OpenDrone-hw/OpenRX-Mono/README.md

# OpenRX Mono

Open-source dual-band (868/915 MHz and 2.4 GHz) ExpressLRS radio control receiver
module with telemetry, for any radio-controlled build: cars, boats, robots and
aircraft. OpenRX Mono uses an ESP32-C3 and one LR1121 with a 2.4 GHz PA/LNA,
sub-GHz matching network and a shared U.FL antenna interface.
It passes the received channels over serial (CRSF) on its RX and TX pads to a
controller, for example a flight controller or a vehicle or robot controller.

<p>
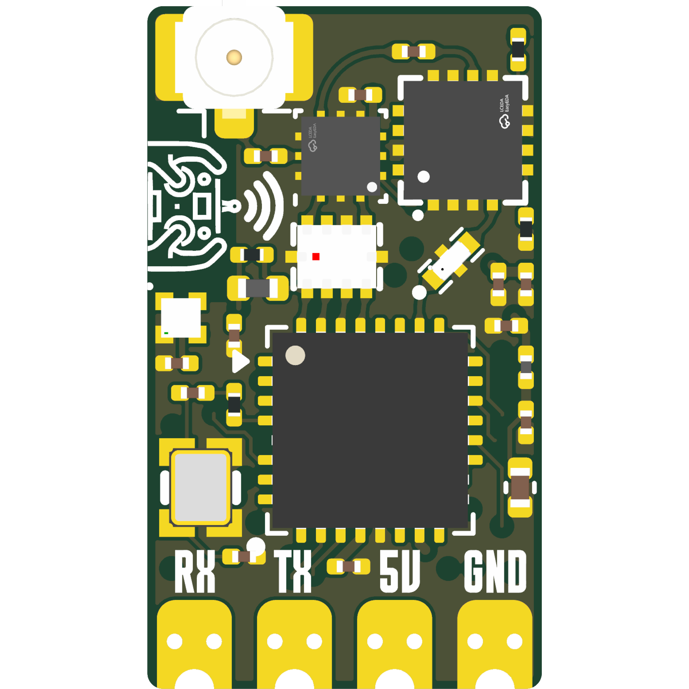
[picture p1: images/front.png]
OpenRX Mono front

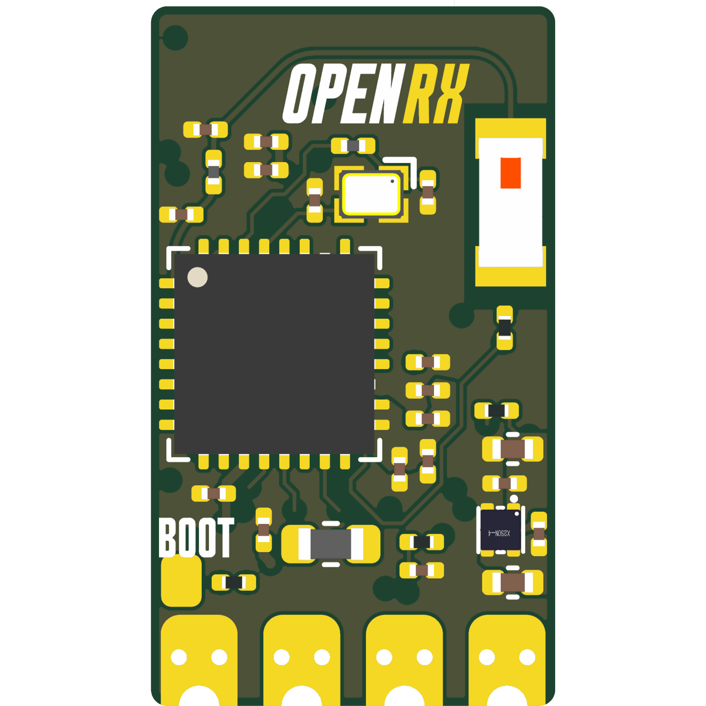
[picture p2: images/back.png]
OpenRX Mono back

</p>







## Specifications

| | |
|---|---|
| Band | 2.4 GHz and sub-GHz |
| Radio | LR1121 |
| Antenna | U.FL |
| Telemetry power | Up to 22 dBm (158 mW) |
| Protocol | CRSF |
| MCU | ESP32-C3 |
| Input | 5 V pad |
| Firmware | ExpressLRS |
| Flashing | Betaflight passthrough or Wi-Fi |
| Dimensions | 10.0 x 17.3 mm |
| PCB | 6-layer, 1.0 mm |

Technical write-up, part list and layout constraints: [AGENTS.md](AGENTS.md).

## In the line

What pairs with what, and what is available:
[opendrone.be](https://opendrone.be).

## Contributing

See [CONTRIBUTING.md](CONTRIBUTING.md).

## License

Hardware licensed under [CERN-OHL-S-2.0](https://ohwr.org/cern_ohl_s_v2.txt),
see [LICENSE](LICENSE).
