OpenDrone-hw/OpenRX-Mono/hardware/OpenRX-Mono.kicad_pcb

## KiCad design hardware/OpenRX-Mono.kicad_pcb (2026-09-19)

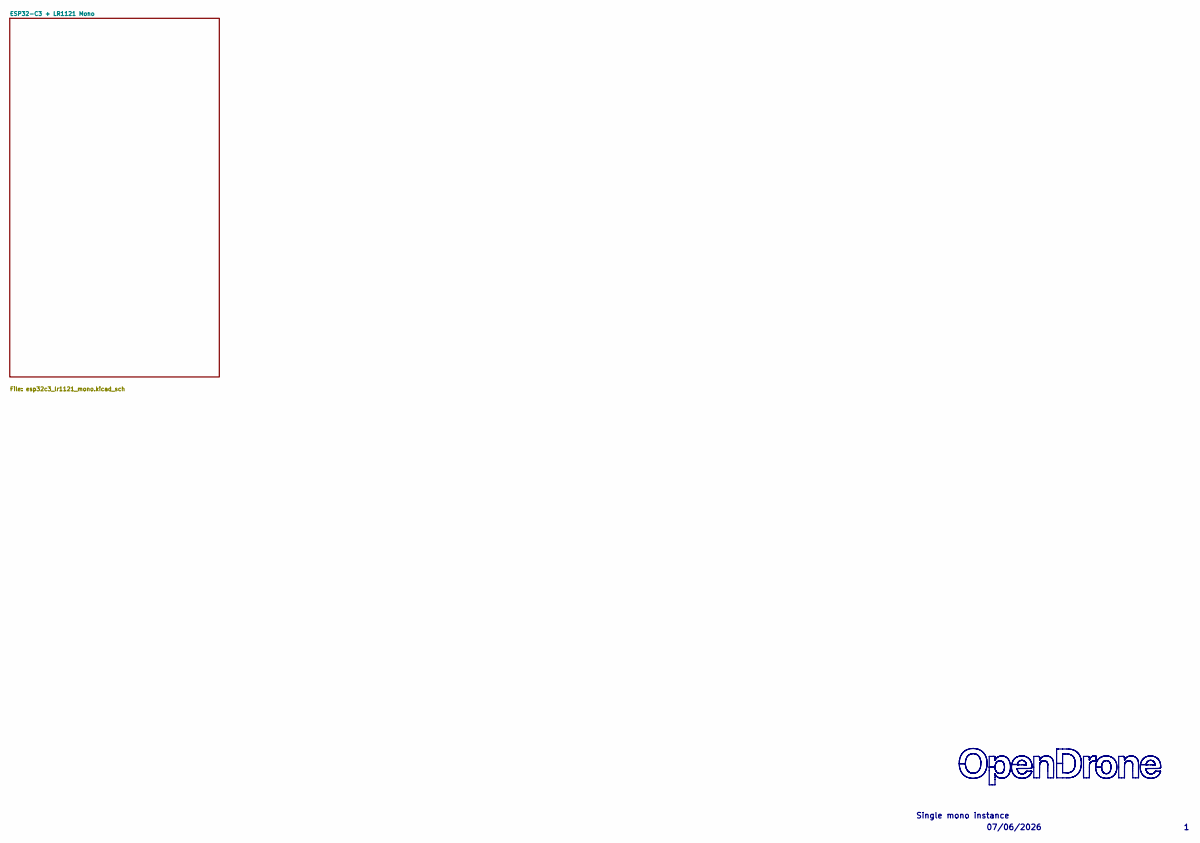
[picture p3: schematic OpenRX-Mono.kicad_sch]

Notes on the sheet:
07/06/2026
Single mono instance

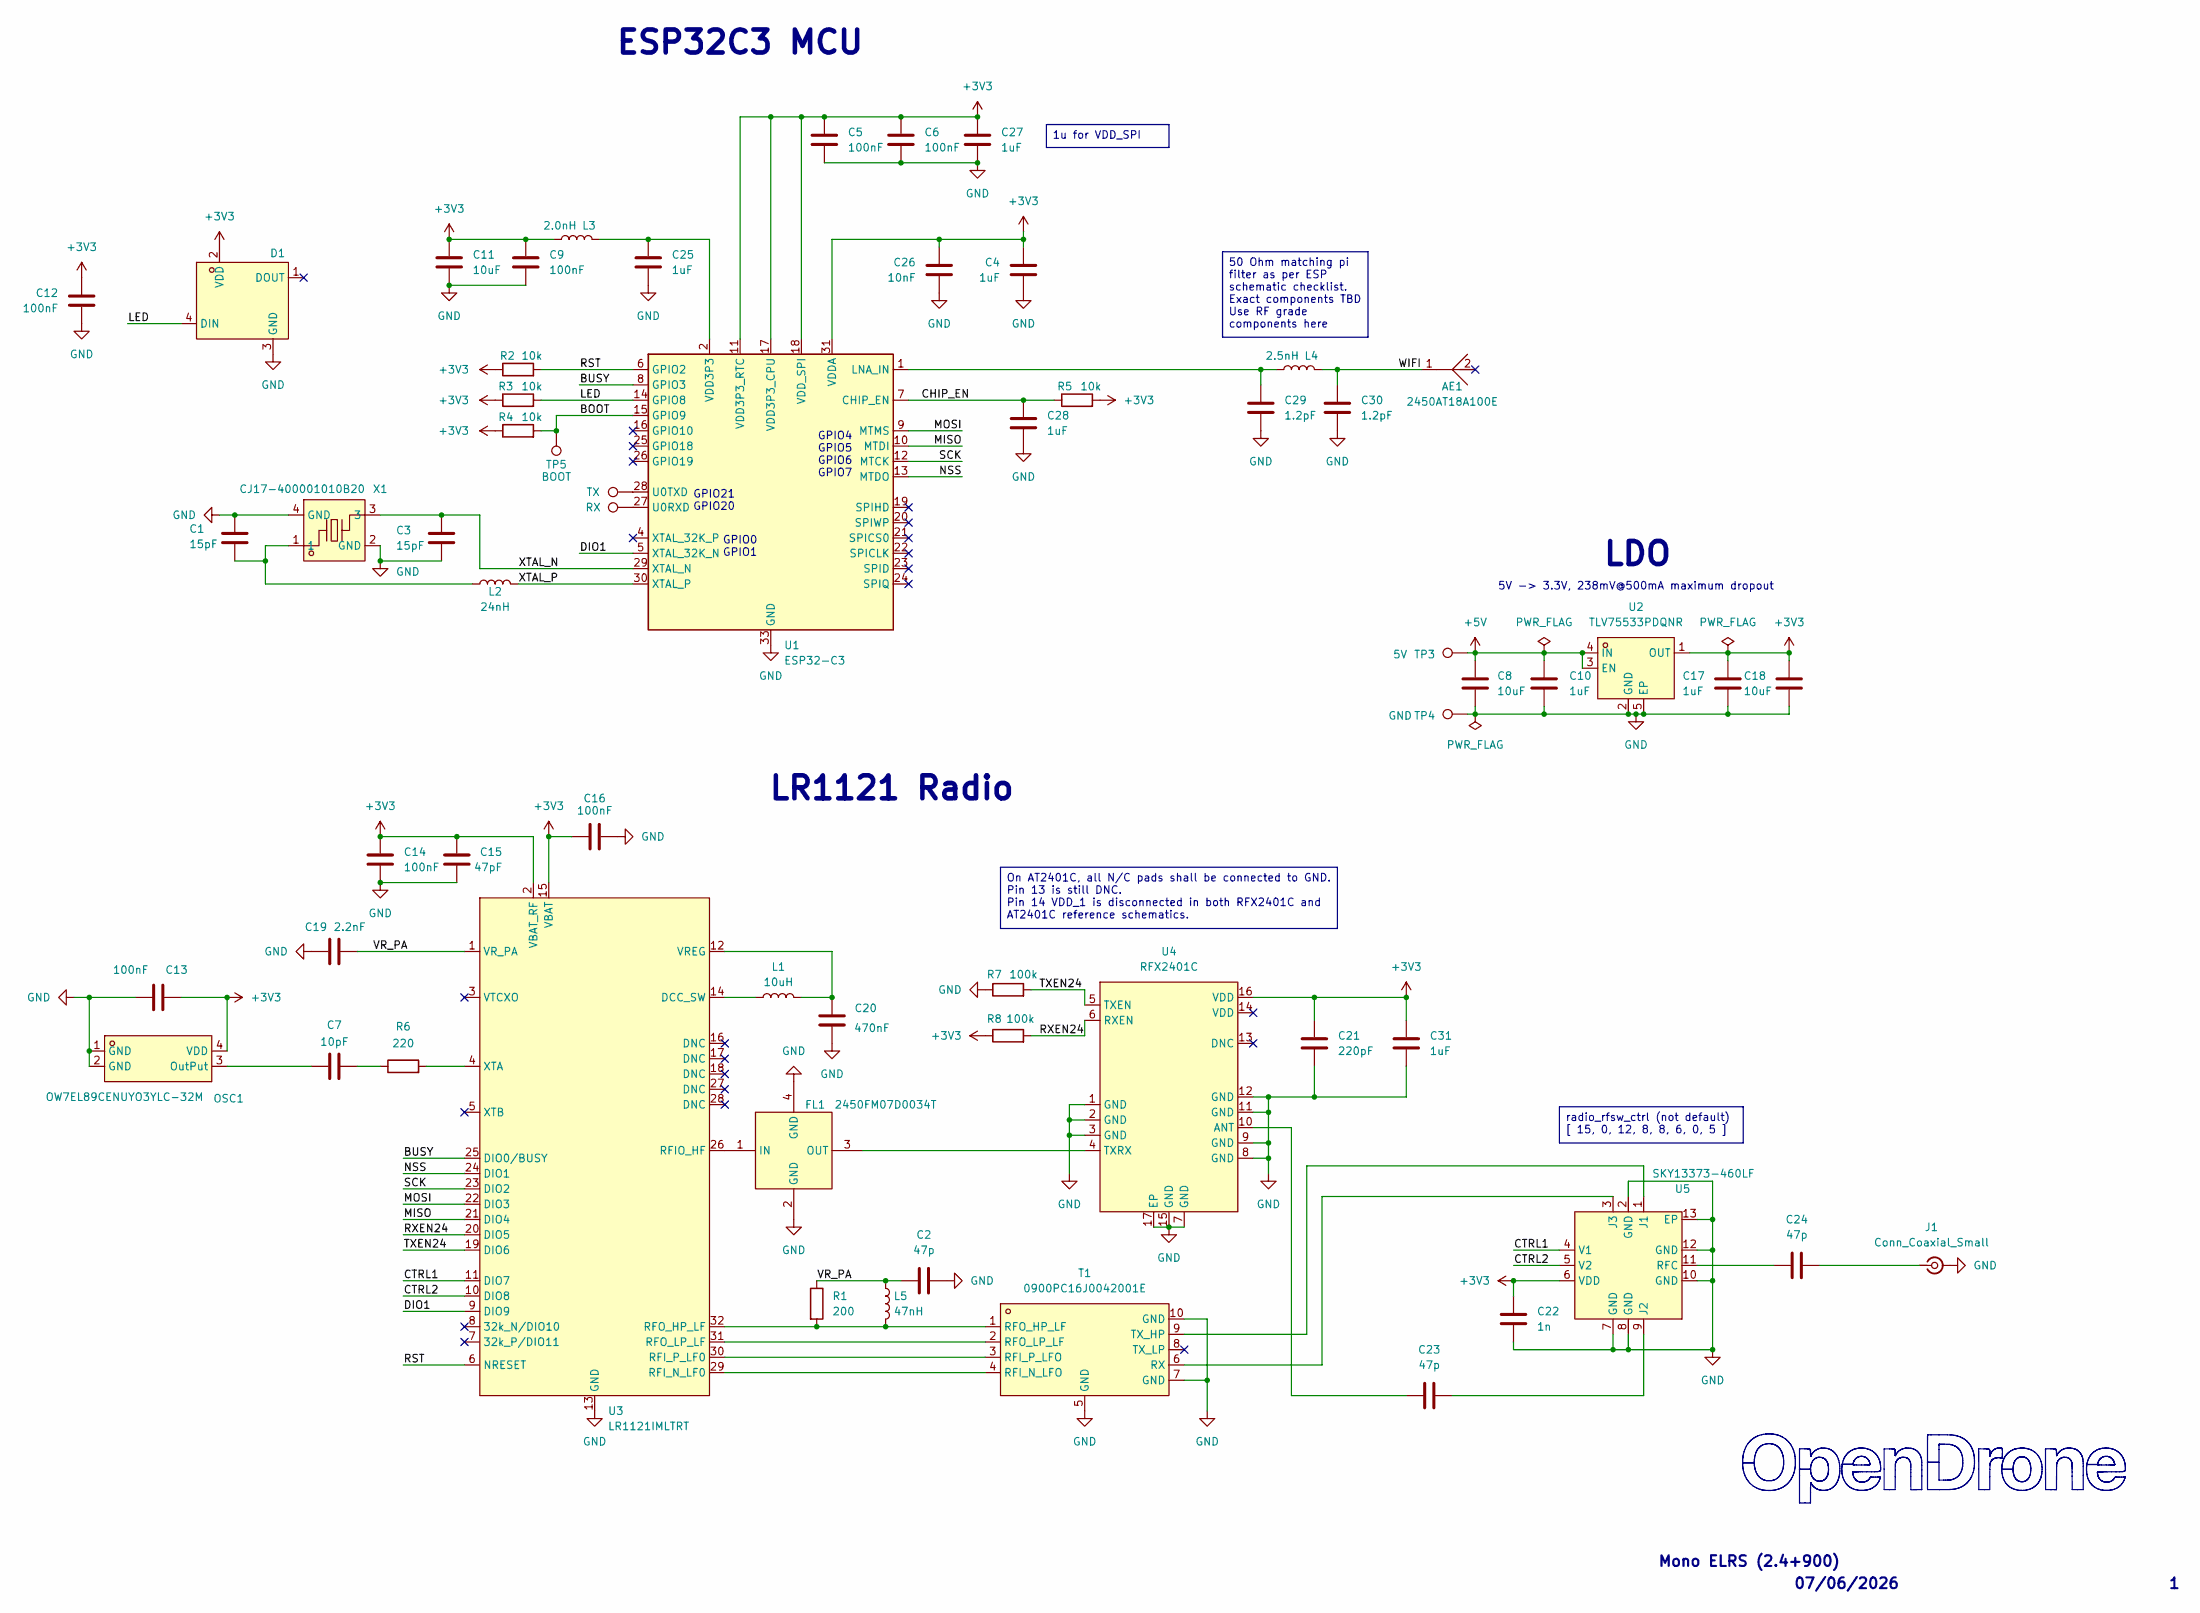
[picture p4: schematic esp32c3_lr1121_mono.kicad_sch]

Parts:
AE1: 2450AT18A100E; ANT-SMD_L3.2-W1.6; MPN 2450AT18A100E; LCSC Part C89334
C1, C3: 15pF; C_0201_0603Metric; MPN GRM0335C1H150JA01D; LCSC C85891
C2, C23, C24: 47p; C_0201_0603Metric; MPN GRM0335C1H470JA01D; LCSC C85908
C4, C10, C17, C25, C27, C28, C31: 1uF; C_0201_0603Metric; MPN GRM033R61A105ME44D; LCSC C76935
C5, C6, C9, C12, C13, C14, C16: 100nF; C_0201_0603Metric; MPN GRM033R61E104KE14D; LCSC C76939
C7: 10pF; C_0201_0603Metric; MPN GRM0335C1H100FA01D; LCSC C384956
C8, C18: 10uF; C_0402_1005Metric; MPN CL05A106MQ5NUNC; LCSC C15525
C11: 10uF; C_0402_1005Metric; MPN GRM155R60J106ME44D; LCSC C76991
C15: 47pF; C_0201_0603Metric; MPN GRM0335C1H470JA01D; LCSC C85908
C19: 2.2nF; C_0201_0603Metric; MPN GRM033R71E222KA12D; LCSC C161488
C20: 470nF; C_0201_0603Metric; MPN GRM033R60J474KE90D; LCSC C85926
C21: 220pF; C_0201_0603Metric; MPN GRM0335C1E221JA01D; LCSC C907939
C22: 1n; C_0201_0603Metric; MPN GRM033R71H102KA12D; LCSC C85934
C26: 10nF; C_0201_0603Metric; MPN GRM033R61A103KA01J; LCSC C2168164
C29, C30: 1.2pF; C_0201_0603Metric; MPN GRM0335C1H1R2BA01D; LCSC C85895
D1: XL-1010RGBC-WS2812B; LED-SMD_4P-L1.0-W1.0-TL_XL-1010RGBC-WS2812B; MPN XL-1010RGBC-2812B; LCSC C5349953
FL1: 2450FM07D0034T; FILTER-SMD_4P-L1.0-W0.5-L; MPN 2450FM07D0034T; LCSC Part_1 C2651081
J1: Conn_Coaxial_Small; U.FL_Hirose_U.FL-R-SMT-1_Vertical; MPN U.FL-R-SMT-1(80); LCSC C88374
L1: 10uH; L_0603_1608Metric; MPN MLZ1608N100LT000; LCSC C194437
L2: 24nH; L_0201_0603Metric; MPN LQP03TN24NH02D; LCSC C206441
L3: 2.0nH; L_0201_0603Metric; MPN LQP03TN2N0B02D; LCSC C86125
L4: 2.5nH; L_0201_0603Metric; MPN LQP03TN2N5C02D; LCSC C206435
L5: 47nH; L_0402_1005Metric; MPN LQW15AN47NJ00D; LCSC C192855
OSC1: OW7EL89CENUYO3YLC-32M; OSC-SMD_4P-L2.0-W1.6-BL_TXC_7Z; MPN OW7EL89CENUYO3YLC-32M; LCSC C22381772
R1: 200; R_0201_0603Metric; MPN RC0201FR-07200RL; LCSC C274337
R2, R3, R4, R5: 10k; R_0201_0603Metric; MPN RC0201FR-0710KL; LCSC C106225
R6: 220; R_0201_0603Metric; MPN ERJ-1GNF2200C; LCSC C2074788
R7, R8: 100k; R_0201_0603Metric; MPN RC0201FR-07100KL; LCSC C106224
T1: 0900PC16J0042001E; FILTER-SMD_10P-L2.0-W1.6-BL; MPN 0900PC16J0042001E; LCSC C19842466
TP1: RX; SolderPad_1.2x2.0mm
TP2: TX; SolderPad_1.2x2.0mm
TP3: 5V; SolderPad_1.2x2.0mm
TP4: GND; SolderPad_1.2x2.0mm
TP5: BOOT; SolderPad_1.2x2.0mm
U1: ESP32-C3; QFN-32-1EP_5x5mm_P0.5mm_EP3.7x3.7mm; MPN ESP32-C3FH4; LCSC C2858491
U2: TLV75533PDQNR; X2SON-4_L1.0-W1.0-P0.65-TL-EP; MPN TLV75533PDQNR; LCSC Part C2861882
U3: LR1121IMLTRT; QFN-32-1EP_5x5mm_P0.5mm_EP3.7x3.7mm; MPN LR1121IMLTRT; LCSC C7498014
U4: RFX2401C; QFN-16_L3.0-W3.0-P0.50-BL-EP1.7; MPN RFX2401C; LCSC C19213
U5: SKY13373-460LF; QFN-12_EP_2x2_Pitch0.5mm; MPN SKY13373-460LF; LCSC C150853
X1: CJ17-400001010B20; CRYSTAL-SMD_4P-L1.6-W1.2-BL; MPN CJ17-400001010B20; LCSC Part C2875272

Connections:
+3V3: C4.1, C5.1, C6.1, C9.1, C11.1, C12.1, C13.2, C14.1, C15.1, C16.1, C17.1, C18.1, C21.1, C22.1, C26.1, C27.1, C31.1, D1.2 (VDD), L3.2, OSC1.4 (VDD), R2.1, R3.1, R4.1, R5.2, R8.1, U1.11 (VDD3P3_RTC), U1.17 (VDD3P3_CPU), U1.18 (VDD_SPI), U1.31 (VDDA), U1.32 (VDDA), U2.1 (OUT), U3.2 (VBAT_RF), U3.15 (VBAT), U4.16 (VDD), U5.6 (VDD)
+5V: C8.1, C10.1, TP3.1 (1_1), U2.3 (EN), U2.4 (IN)
/ESP32-C3 + LR1121 Mono/BOOT: R4.2, TP5.1 (1_1), U1.15 (GPIO9)
/ESP32-C3 + LR1121 Mono/BUSY: U1.8 (GPIO3), U3.25 (DIO0/BUSY)
/ESP32-C3 + LR1121 Mono/CHIP_EN: C28.1, R5.1, U1.7 (CHIP_EN)
/ESP32-C3 + LR1121 Mono/CTRL1: U3.11 (DIO7), U5.4 (V1)
/ESP32-C3 + LR1121 Mono/CTRL2: U3.10 (DIO8), U5.5 (V2)
/ESP32-C3 + LR1121 Mono/DIO1: U1.5 (XTAL_32K_N), U3.9 (DIO9)
/ESP32-C3 + LR1121 Mono/LED: D1.4 (DIN), R3.2, U1.14 (GPIO8)
/ESP32-C3 + LR1121 Mono/MISO: U1.10 (MTDI), U3.21 (DIO4)
/ESP32-C3 + LR1121 Mono/MOSI: U1.9 (MTMS), U3.22 (DIO3)
/ESP32-C3 + LR1121 Mono/NSS: U1.13 (MTDO), U3.24 (DIO1)
/ESP32-C3 + LR1121 Mono/RST: R2.2, U1.6 (GPIO2), U3.6 (NRESET)
/ESP32-C3 + LR1121 Mono/RXEN24: R8.2, U3.20 (DIO5), U4.6 (RXEN)
/ESP32-C3 + LR1121 Mono/SCK: U1.12 (MTCK), U3.23 (DIO2)
/ESP32-C3 + LR1121 Mono/TXEN24: R7.2, U3.19 (DIO6), U4.5 (TXEN)
/ESP32-C3 + LR1121 Mono/VR_PA: C2.1, C19.1, L5.1, R1.1, U3.1 (VR_PA)
/ESP32-C3 + LR1121 Mono/WIFI: AE1.1, C30.1, L4.1
/ESP32-C3 + LR1121 Mono/XTAL_N: C3.1, U1.29 (XTAL_N), X1.3
/ESP32-C3 + LR1121 Mono/XTAL_P: L2.2, U1.30 (XTAL_P)
GND: C1.2, C2.2, C3.2, C4.2, C5.2, C6.2, C8.2, C9.2, C10.2, C11.2, C12.2, C13.1, C14.2, C15.2, C16.2, C17.2, C18.2, C19.2, C20.1, C21.2, C22.2, C25.2, C26.2, C27.2, C28.2, C29.2, C30.2, C31.2, D1.3 (GND), FL1.2 (GND), FL1.4 (GND), J1.2 (Ext), OSC1.1 (GND), OSC1.2 (GND), R7.1, T1.5 (GND), T1.7 (GND), T1.10 (GND), TP4.1 (1_1), U1.33 (GND), U2.2 (GND), U2.5 (EP), U3.13 (GND), U3.33 (EP), U4.1 (GND), U4.2 (GND), U4.3 (GND), U4.7 (GND), U4.8 (GND), U4.9 (GND), U4.11 (GND), U4.12 (GND), U4.15 (GND), U4.17 (EP), U5.2 (GND), U5.7 (GND), U5.8 (GND), U5.10 (GND), U5.12 (GND), U5.13 (EP), X1.2 (GND), X1.4 (GND)
unnamed: C1.1, L2.1, X1.1
unnamed: C7.1, R6.1
unnamed: C25.1, L3.1, U1.2 (VDD3P3), U1.3 (VDD3P3)
unnamed: FL1.1 (IN), U3.26 (RFIO_HF)
unnamed: FL1.3 (OUT), U4.4 (TXRX)
unnamed: C24.2, J1.1 (In)
unnamed: C7.2, OSC1.3 (OutPut)
unnamed: T1.4 (RFI_N_LFO), U3.29 (RFI_N_LF0)
unnamed: T1.3 (RFI_P_LFO), U3.30 (RFI_P_LF0)
unnamed: L5.2, R1.2, T1.1 (RFO_HP_LF), U3.32 (RFO_HP_LF)
unnamed: T1.2 (RFO_LP_LF), U3.31 (RFO_LP_LF)
unnamed: T1.6 (RX), U5.3 (J3)
unnamed: T1.9 (TX_HP), U5.1 (J1)
unnamed: C29.1, L4.2, U1.1 (LNA_IN)
unnamed: TP1.1 (1_1), U1.27 (U0RXD)
unnamed: TP2.1 (1_1), U1.28 (U0TXD)
unnamed: L1.1, U3.14 (DCC_SW)
unnamed: C20.2, L1.2, U3.12 (VREG)
unnamed: R6.2, U3.4 (XTA)
unnamed: C23.1, U4.10 (ANT)
unnamed: C23.2, U5.9 (J2)
unnamed: C24.1, U5.11 (RFC)

Notes on the sheet:
GPIO0 GPIO1
LR1121 Radio
GPIO21 GPIO20
5V -> 3.3V, 238mV@500mA maximum dropout
07/06/2026
ESP32C3 MCU
LDO
Mono ELRS (2.4+900)
GPIO4 GPIO5 GPIO6 GPIO7
On AT2401C, all N/C pads shall be connected to GND. Pin 13 is still DNC. Pin 14 VDD_1 is disconnected in both RFX2401C and AT2401C reference schematics.
50 Ohm matching pi filter as per ESP schematic checklist. Exact components TBD Use RF grade components here
radio_rfsw_ctrl (not default) [ 15, 0, 12, 8, 8, 6, 0, 5 ]
1u for VDD_SPI

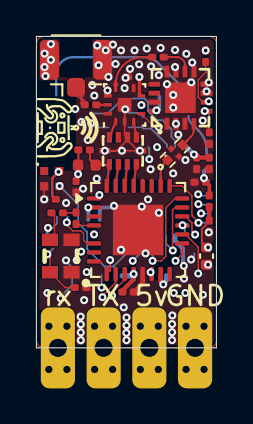
[picture p5: board OpenRX-Mono.kicad_pcb from above]

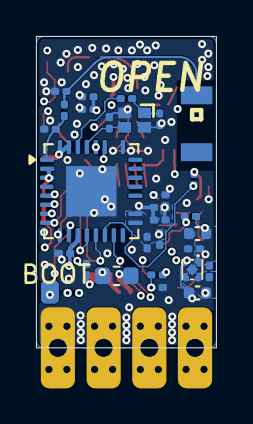
[picture p6: board OpenRX-Mono.kicad_pcb from below]

Board: 6 copper layers, 10.0 x 17.3 mm, 61 parts (30 on the bottom side), 43 nets.
