OpenDrone-hw/OpenRX-Mono/(commit log)

2026-03-23 Consolidate docs: 1 README + KICAD_WORKFLOW + 1 DESIGN.md per receiver
    - Merge SCHEMATIC.md + BOM.md into single DESIGN.md per receiver
    - Delete OPENRX_ELRS_4_RECEIVER_PORTFOLIO.md (content integrated)
    - Delete REPO_AUDIT_2026-03-23.md (issues addressed)
    - Fold CORE_BOM into README.md architecture table
    - Rename KICAD_WORKFLOW_AND_ELRS_COMPATIBILITY.md to KICAD_WORKFLOW.md
    - Rewrite KICAD_WORKFLOW with step-by-step capture instructions
    - Add shared libs and starter shared sheet from audit agent
2026-03-23 Fix all DESIGN.md: RFX2401C, DEA LPF, LR1121 pinout, FEM control
    - Lite: remove L-match network, use DEA102700LT-6307A2 only
    - Nano: clarify DEA LPF path, mark 0.3pF as mandatory, SE2431L as EOL
    - 900: fix LR1121 RFSW description, confirm 4x4mm package
    - Dual: SE2431L→RFX2401C, FEM via LR1121 RFSW not MCU GPIO, BOM $9→$7.62
    - PWM: SE2431L→RFX2401C, DEA LPF + 0.3pF path, BOM $7.40→$6.02
    - Gemini: SE2431L→RFX2401C, fix FEM control model, BOM $10.84→$9.46
2026-03-23 Update all DESIGN.md: TLV75533 X2SON LDO, XL-1010 1x1mm LED
    - Lite/Nano/900/Dual: ME6211 SOT-23-5 → TLV75533PDQNR X2SON-4 (1x1mm)
    - Gemini: keeps AP2112K (600mA needed for dual radios)
    - PWM: keeps AMS1117 (needs >6V input range)
    - All: WS2812B-2020 → XL-1010RGBC-WS2812B (1x1mm)
    - Updated cap values for TLV755 (1uF local + 10uF bulk)
2026-03-23 Import U.FL-R-SMT-1(80) UFL connector into shared library (C88374)
2026-03-23 Import Molex 479480001 tower ceramic antenna (C152351) for ELRS RF
2026-03-23 Add solder pad footprints: 1.0x1.5mm and 1.0x0.8mm compact
2026-03-23 Unify library tables, import RFX2401C, Lite schematic capture
    - All 6 projects now share OpenRX-Shared + OpenRX-Lite lib tables
    - Import RFX2401C (C19213) into shared library with 3D model path fix
    - OpenRX-Lite schematic: 0 ERC errors (captured in KiCad GUI)
    - Add .gitignore for .lck and .history files
2026-03-23 OpenRX-900: add all LCSC fields, fix 4.7uF to 0402
    - C20 (4.7uF): C23733, footprint fixed from 0201 to 0402
    - R5/R6/R7 (100k): C25741, RFSW pull-downs
    - L1 (10uH): C1035, 0603 DC-DC inductor
    - U4 (LR1121): C7498014
    - U5 (32MHz TCXO): C22434888
    - T1 (Johanson IPD): C19842466
    - JP1 (UFL): C88374
    - 0 ERC errors, all components have LCSC fields
2026-03-23 Fix Gemini crystal load caps to 18pF (C62164), matching Lite and Mono
    [OpenRX-Mono.kicad_pcb, OpenRX-Mono.kicad_sch, esp32c3_lr1121_mono.kicad_sch]
2026-03-23 Add LCSC C430052 for 24nH XTAL_P inductor on Mono
    Mono L2 (24nH 0201) was missing LCSC field.
    Lite still needs 24nH inductor added in KiCad GUI.
    Gemini is parked — still a Mono copy, not yet dual-radio.
    [esp32c3_lr1121_mono.kicad_sch]
2026-03-23 OpenRX-Gemini: dual LR1121 schematic complete, 0 ERC errors
    - Radio 1 (U4): sub-GHz via Johanson IPD → JP1 UFL
    - Radio 2 (U9): 2.4GHz via RFX2401C (U10) → DEA (USB2) → JP3 UFL
    - Shared SPI bus (SCK/MISO/MOSI), separate NSS/IRQ/BUSY/RST per radio
    - Radio 2 control: GPIO10=NSS2, GPIO9=IRQ2, GPIO1=BUSY2, GPIO0=RST2
    - FEM driven by Radio 2 RFSW (DIO5→RXEN, DIO6→TXEN)
    - Radio 1 DIO5/DIO6 have 100k pull-downs (disconnected from FEM)
    - No LED (GPIO10 used for NSS2), no boot button (GPIO9 used for IRQ2)
    - Still needs: 10k pull-up on NSS2
    [esp32c3_lr1121_mono.kicad_sch]
2026-03-23 Add SolderPad_1.2x2.0mm with 25% rounded corners, 2.0mm pitch standard
2026-03-23 Swap all solder pads to 1.2x2.0mm rounded (25%) across Lite, Mono, Gemini
    [esp32c3_lr1121_mono.kicad_sch]
2026-03-23 Swap 32MHz TCXO to smaller 2016 package (C22381772)
    OW2EL89 (3225, 3.2x2.5mm) → OW7EL89 (2016, 2.0x1.6mm)
    Same YXC family, same pinout, same specs. Saves 1.2x0.9mm per TCXO.
    Affects Mono (1x) and Gemini (2x).
    [esp32c3_lr1121_mono.kicad_sch]
2026-03-23 Import SKY13588-460LF SP3T RF switch (C2151906) into shared library
2026-03-23 Final topology: Mono + Gemini netlist with SKY13588 RF switch
    - SKY13588-460LF imported into shared library
    - Complete netlist for Mono (1×LR1121 + SKY13588 + Johanson IPD + DEA LPF → 1 UFL)
    - Gemini = 2× Mono RF chains + ESP32-C3 True Diversity GPIO mapping
    - GPIO maps match official ELRS Generic C3 LR1121 and True Diversity targets
    - Routing notes for RF paths included
    - Mono needs complete GPIO rewire to match ELRS target
2026-03-23 FINAL_NETLIST v3: SKY13588 as band combiner, RFX2401C kept for 100mW
    Based on RadioMaster XR4 teardown analysis:
    - SKY13588 serves as both sub-GHz path switch AND band combiner
    - Johanson IPD in direct-tie mode (RX/TX_LP/TX_HP joined) → SKY13588 J1
    - 2.4GHz: RFIO_HF → DEA LPF → RFX2401C → SKY13588 J2
    - SKY13588 RFC → DC block → UFL → dual-band antenna
    - RFX2401C kept for 100mW market parity
    - Button imported (C2976675, 3x2mm SMD)
    - RFSW truth table: DIO7/DIO8 control band, DIO5/DIO6 control RFX2401C
    [esp32c3_lr1121_mono.kicad_sch]
2026-03-23 Mono schematic v4: complete RF chain verified
    Verified netlist:
    - LR1121 → IPD (direct-tie, pins 6+8+9 joined) → SKY13588 J1 ✓
    - LR1121 RFIO_HF → DEA LPF → RFX2401C TXRX ✓
    - RFX2401C ANT → 0.3pF shunt → SKY13588 J2 ✓
    - SKY13588 RFC → UFL ✓
    - DIO7→V1, DIO8→V2 (band select) ✓
    - DIO5→RXEN, DIO6→TXEN (RFX2401C control) ✓
    - GPIO map matches Generic C3 LR1121 target ✓
    - Added LCSC to 220pF, RFX2401C, button
    - 1 ERC error: GPIO10 needs NC marker
    - 0.3pF has no LCSC (layout pad for tuning)
    [esp32c3_lr1121_mono.kicad_sch]
2026-03-24 Gemini: copy Mono schematic as base for dual-radio build
    [OpenRX-Mono.kicad_pcb, esp32c3_lr1121_mono.kicad_sch]
2026-03-24 Gemini: copy Mono schematic + PCB as starting point
    [OpenRX-Mono.kicad_pcb, esp32c3_lr1121_mono.kicad_sch]
2026-03-24 Copy Gemini PCB layout to Mono
    [OpenRX-Mono.kicad_pcb]
2026-03-24 Apply JLCPCB 6-layer advanced DRC rules to Mono and Gemini
    Rules applied:
    - Min clearance: 0.09mm (3.5mil)
    - Min track width: 0.09mm (3.5mil)
    - Min via diameter: 0.25mm
    - Min via drill: 0.15mm
    - Min annular ring: 0.05mm
    - Min hole-to-hole: 0.25mm
    - Default net class clearance: 0.09mm (was 0.2mm — this was the override)
    - Default track width: 0.1mm
    - Zone clearance: 0.09mm (was 0.5mm)
2026-03-24 Repo cleanup: final state for handoff
    - Clean README with architecture, BOM, CE notes, status
    - Remove dated analysis files (absorbed into FINAL_NETLIST + KICAD_WORKFLOW)
    - Remove stale OpenRX-Dual (archived), ERC reports, backups, prl files
    - Updated .gitignore for .kicad_dru, production backups
    - CERN-OHL-S v2 license confirmed
    - 3 active projects: Lite, Mono, Gemini
    - Schematics final, initial PCB layouts done, routing in progress
    [OpenRX-Mono.kicad_pcb, esp32c3_lr1121_mono.kicad_sch]
2026-04-06 Update schematics: Mono RF rewiring, SKY13414 port mapping, shared libs
    Mono: disconnect IPD TX_LP (unused by ELRS), route TX_HP→RF3, RX→RF1,
    RFX2401C ANT→RF4. Matches BetaFPV SuperX topology.
    [OpenRX-Mono.kicad_pcb, esp32c3_lr1121_mono.kicad_sch]
2026-04-06 Add Lite-UFL variant, ELRS targets, new footprints and 3D models
    - OpenRX-Lite-UFL: UFL antenna variant of Lite ceramic
    - ELRS target JSONs: Lite 2400, Mono LR1121, Gemini LR1121
    - radio_rfsw_ctrl: [15,0,0,8,8,14,0,13] for Mono/Gemini
    - SKY13414 QFN-14 footprint + 3D model
    - 2450FM07D0034 filter footprint
    - BOM LCSC passives script
2026-04-06 Add component datasheets and BOM index
    Local datasheet cache for all active RF components: LR1121, SX1281,
    SKY13414, SKY13373, RFX2401C, 2450FM07D0034, 0900PC16J0042001E,
    2000PC15C0040001E, 2450AT18A100E, BALF-SPI2-01D3, passives.
2026-04-06 Update all DESIGN.md docs: RF paths, GPIO maps, rfsw_ctrl, known bugs
    - Mono: new SKY13414 port mapping (RF1=RX, RF3=TX_HP, RF4=2.4GHz),
    rfsw_ctrl [15,0,0,8,8,14,0,13], GPIO map, impedance notes
    - Lite/Lite-UFL: GPIO map, no-boot-button note, SPI pin difference
    - Gemini: document DIO7-2/DIO8-2 wiring bug, stale component list
    - README: current lineup table
2026-04-21 initial routing for all
    [OpenRX-Mono.kicad_pcb, esp32c3_lr1121_mono.kicad_sch]
2026-04-27 final route
    [OpenRX-Mono.kicad_pcb]
2026-04-28 Set via netclass + dimension defaults to 0.3/0.2mm on all 4 boards
    [OpenRX-Mono.kicad_pcb]
2026-04-28 switch to 0.2mm vias
    [OpenRX-Mono.kicad_pcb]
2026-04-28 gitignore JLC per-quote BOM markdown drops
2026-05-08 OpenRX Lite (UFL + molex)
    [OpenRX-Mono.kicad_pcb, esp32c3_lr1121_mono.kicad_sch, mono.step]
2026-06-06 docs: standardized 3D board renders for all RX variants (front/back)
2026-06-07 docs: populate DOC_* text variables for all RX variants
    Set DOC_NAME/HANDLE/VARIANT/TAGLINE/FIRMWARE/PROTOCOL/MCU/INPUT/RATING in
    each variant .kicad_pro, derived from the schematics and ELRS target JSON,
    matching the sibling OpenDrone repos' convention.
2026-06-07 docs: reconcile README against schematics, add DESIGN_NOTES + all-variant renders
    - README rewritten against schematic/netlist ground truth (OpenFC-Lite-Mini-style
    layout, all four variants' front/back renders side-by-side).
    - Corrected antenna roles: AE1 (2450AT18A100E ceramic) is the ESP32-C3 Wi-Fi/OTA
    antenna (net WIFI) on every variant; the ELRS link antenna is FL1-OUT's load —
    47948-0001 chip antenna on Lite, U.FL on Lite-UFL/Mono/Gemini.
    - Pad pinout + per-variant pin map derived from netlists and ELRS target JSON.
    - Corrected: two distinct radio TCXOs (52 MHz SX1281 / 32 MHz LR1121); only Gemini
    has a tactile button; per-variant LED GPIO.
    - DESIGN_NOTES.md mirrors the on-can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
2026-06-07 docs: via-free board renders
    Re-render top/bottom board images with vias removed for a cleaner look.
    KiCad cannot render tented vias, so vias were temporarily stripped via the
    pcbnew API for rendering only; source .kicad_pcb files are unchanged.
2026-06-07 docs: re-render boards without floor shadows
    Re-render top/bottom images at basic quality so the soldermask floor
    shadow halo is gone. Vias still stripped for the render only (via pcbnew),
    source .kicad_pcb files unchanged.
2026-06-07 docs: render boards without solder paste
    Strip the solder-paste layer (and vias) for the render only so SMD pads
    show as clean copper instead of gray paste deposits. Source .kicad_pcb
    files unchanged.
2026-06-07 docs: remove DESIGN_NOTES, trim README boilerplate
    - Delete DESIGN_NOTES.md (and its gitignore exception)
    - Drop the Manufacturing / production-export section
    - Remove the canonical-reference boilerplate blurb
    - ESC boards: AM32 bootloader ships pre-loaded, firmware flashed via am32.ca
2026-08-04 chore: wire shared Incutec KiCad library
    Adds incutec-hw/KiCad-Library as submodule at libs/KiCad-Library, pinned
    to the feat/complete-library build. Project lib tables gain the Incutec
    sym+fp entries via ${KIPRJMOD} relative paths. Existing local libraries
    untouched (frozen, see the library repo MANIFEST).
2026-08-05 shared: refresh QFN-12/QFN-16 footprints, add RFX2401C 3D models
    Footprint editor resave of the two QFN footprints and new
    RFX2401C QFN-16 EP1.7 step/wrl models referenced by Mono and Gemini.
2026-08-05 OpenRX-Mono: PCB doc properties, 3D model fixes, target update, renders
    Board file gains DOC_* properties and corrected 3D model references
    (RFX2401C EP1.7, QFN-12 BL). ELRS target: corrected LR1121 RF switch
    control table, enable radio DCDC, WS2812 RGB LED instead of plain LED.
    Re-rendered README images.
    [OpenRX-Mono.kicad_pcb]
2026-08-05 docs: adopt OpenDrone repo standard
    README restructured to the standard section order; deep antenna, pad,
    pin-map, and firmware-target detail relocated to a new family DESIGN.md.
    Per-variant DESIGN.md files reconciled against the committed schematics,
    PCBs, and ELRS target JSON: SKY13373-460LF (not SKY13414), current
    radio_rfsw_ctrl values, real Gemini sheet hierarchy and refdes, Lite
    DESIGN.md no longer a copy of the Lite-UFL one. Adds CONTRIBUTING.md,
    AGENTS.md, CHANGELOG.md.
    Fact-check fixes: board sizes at Edge.Cuts centerline, KiCad 10 (not
    9/10), library claim corrected to OpenRX-Shared + Incutec submodule +
    embedded stock footprints, ELRS targets described as in-repo (not
    upstream),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
2026-08-05 chore: track per-variant Fabrication Toolkit config
2026-08-05 changed 3.3V supply on clocks, added text, enlarged pads
    [OpenRX-Mono.kicad_pcb, OpenRX-Mono.kicad_sch, esp32c3_lr1121_mono.kicad_sch]
2026-08-06 Rewrite CONTRIBUTING for humans: file locking, render proof, sign-off
    KiCad files cannot be merged, so the doc now leads with claiming files via
    git lfs lock and issue-first discussion, the convention used by LumenPnP and
    Ultimate Hacking Keyboard. Adds .gitattributes marking design files lockable.
    Drops the internal documentation-style rule that meant nothing to contributors.
2026-08-06 Untrack the bench flashing guide
    It documents an internal bench setup and points at a local-only ExpressLRS
    fork, so it is not usable by anyone cloning the repo. Per-board flashing
    guides get written after bringup. File stays on disk.
2026-08-06 Fix contradictions and duplicated information
    Contradictions:
    - Restore shared/libs/OpenRX-Shared.kicad_sym, dropped by accident in 0bb1465.
    All 7 sym-lib-tables point at it and the schematics carry 20 OpenRX-Shared:
    lib_ids, so a fresh clone could not edit or place any symbol. Restored
    byte-exact from 0bb1465^.
    - README board sizes now match Edge.Cuts: Lite and Lite-UFL 10.0 x 11.5 mm,
    Mono 10.0 x 17.3 mm. Gemini was already correct at 17.0 x 15.7 mm.
    - Remove the nine dead FLASHING.md links. The file is untracked and gitignored.
    Facts that only lived behind those links are inlined: the LR1121 DIO5-DIO8 to
    RFX2401C/SKY13373 mapping, the ExpressLRS 3.5.0 minimum, and the Mono/Gem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
2026-08-06 Local libraries are the working default again
    New parts go into this repo's local libraries. KiCad-Library becomes a mirror
    of parts we already use or stock, worth checking first because a hit means we
    have sourced it before. Promotion into it is a separate step.
2026-08-11 update all RXs rev2 with fab files
    [OpenRX-Mono-B_Cu.gbr, OpenRX-Mono-B_Mask.gbr, OpenRX-Mono-B_Paste.gbr, OpenRX-Mono-B_Silkscreen.gbr, OpenRX-Mono-Edge_Cuts.gbr, OpenRX-Mono-F_Cu.gbr, OpenRX-Mono-F_Mask.gbr, OpenRX-Mono-F_Paste.gbr]
2026-08-12 Restore the QFN-12 3D model on the Mono SKY13373
    U5 carried no 3D model reference at all, so it rendered as nothing in the 3D
    viewer with no error to explain it. The library was never at fault:
    OpenRX-Shared.pretty/QFN-12_EP_2x2_Pitch0.5mm.kicad_mod already carries the
    model, it was the copy embedded in the board that lacked it.
    This restores the part of 68d07bb that was dropped when PR #19 was closed as
    superseded by #23. #23 only carried the two documentation commits, so the PCB
    half was lost. The RFX2401C model choice from that commit is deliberately left
    out, it remains an open decision against Bastian's generic QFN-16.
    Model reference only. Footprint, pad, segment, via, zone and net c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
    [OpenRX-Mono.kicad_pcb]
2026-08-12 Add the ExpressLRS logo footprint to the shared library
    Graphics only, no pads, generated by bitmap2component. Marked board_only,
    exclude_from_pos_files and exclude_from_bom, so it stays out of the CPL and the
    BOM. Carries artwork on both F.SilkS and F.Cu; drop the F.Cu polygons after
    placing if silkscreen alone is wanted.
2026-08-12 Rev 2 board work: routing optimisations, logo placement, 3D model fixes
    Routing reworked on Lite (segments 313 to 256, vias 60 to 89), Lite-UFL
    (317 to 269, 61 to 85) and Gemini (682 to 688, 196 to 243). ExpressLRS logo
    placed on Mono.
    3D model fixes on Gemini and Mono:
    - RFX2401C (U4, U7) pointed at QFN-16_L3.0-W3.0-H0.9-P0.50.wrl with an offset
    of (-951.61, 821.31, 0), so the body rendered about a metre off the board and
    the land looked bare in the viewer. Repointed at the RFX2401C model that
    OpenRX-Shared.pretty/QFN-16_L3.0-W3.0-P0.50-BL-EP1.7.kicad_mod specifies,
    offset zeroed, 270 degree rotation kept.
    - SKY13373 (U5, U8) carried no model reference at all. Added, matching the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
    [OpenRX-Mono.kicad_pcb]
2026-08-13 Standardise: six design docs into one AGENTS.md, trimmed README (#26)
    Adopts the org-wide shape for a multi-variant repo. The root DESIGN.md and the
    four per-variant DESIGN.md files become a single AGENTS.md: the family circuit,
    antennas, pad map, pin map and firmware targets once, then a section per
    variant. Cross-references between the old files become in-document anchors, all
    of which resolve.
    Every variant gains a .kicad_dru carrying the canonical block. Lite and
    Lite-UFL had none at all; Mono and Gemini had a single rule conditioned on a
    "50Ohm" netclass that no project in the org defines, so it could never fire.
    README drops the repository layout, build commands and per-variant detai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
2026-08-13 README: standardised link row, specs from the shop, status badge (#28)
    Same shape in every board repo.
    Outbound links move out of prose into one badge row: status, shop, the product's
    Discord channel, its build video, and OSHWA where the board is certified. The
    status badge links to the stage ladder in the org CONTRIBUTING rather than
    describing the stage here.
    The specification table is synced from the product page on opendrone.be, which
    is the maintained copy for now. Long term this goes the other way.
    "In the line" points at opendrone.be instead of listing sibling repos by hand,
    since what pairs with what changes there first.
    Drops the JustFPV teardown line, now the video badge, and o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
2026-08-14 Normalise board setup to the line standard
    The canonical dru's copper-to-copper rule demanded 0.1 mm outer
    clearance against the 0.09 line standard stated in the same file,
    flooding DRC with false errors on standard-routed boards. Removed;
    the project-file floors gate this already. Rule floors set to the
    line standard where the routed board complies, verified by DRC:
    zero new violations.
2026-08-14 Drop the KiCad-Library submodule: nothing references it
    No symbol, footprint or 3D model in the design resolves through
    libs/KiCad-Library; every part is in the repo's local libraries. The
    submodule only cost --recursive clones and pin maintenance. Lib-table
    rows for the dead Incutec nickname removed so KiCad stops warning.
2026-08-14 Rev 3.1 working state: zone refills, fab option names, ordered sets
    Mono and Gemini PCB zone refills and priority renumbering, Lite-UFL J1
    LCSC field, fabrication-toolkit archive names per revision, the dated
    2026-08-06 production sets for Lite-UFL and Mono as the record of what
    was ordered, competitor RX catalogue, stale export STEPs deleted. The
    repo-specific .gitignore tail restores flashing/bringup notes and the
    firmware handoff bundle to local-only, plus regenerable dumps.
    [OpenRX-Mono-B_Courtyard.gbr, OpenRX-Mono-B_Cu.gbl, OpenRX-Mono-B_Fab.gbr, OpenRX-Mono-B_Mask.gbs, OpenRX-Mono-B_Paste.gbp, OpenRX-Mono-B_Silkscreen.gbo, OpenRX-Mono-Edge_Cuts.gm1, OpenRX-Mono-F_Courtyard.gbr]
2026-08-14 Track FLASHING.md, drop the legacy-projects archive from the tip
    FLASHING.md is the per-product flashing and debug reference; people
    cannot use the boards without it, so it is repo content, not a bench
    note. The five superseded designs (44 MB) stay in git history, which is
    what archives are; the tip carries current designs only.
2026-08-14 Rebuild E6 substitute STEP models from the trusted wrl geometry
    The .step files beside these .wrl models were different parts (USB-C
    3.5x oversized, etc), and the upstream LCSC .step is the same wrong
    file, so kicad-cli --subst-models shipped wrong geometry in every STEP
    export while the 3D viewer looked perfect. Rebuilt as tessellated STEP
    solids from the .wrl the viewer renders, via
    OpenDrone-Scripts/kicad/wrl_to_step.py: bbox and origin now match to
    0.000 mm. check_models reports zero E6, export unblocked.
    [OpenRX-Mono.kicad_pcb]
2026-08-14 Rev 2 refresh prep: renders, schematic PDFs, revisions
    The committed board now matches the verified fab export exactly
    (check_export.py C1-C3 clean). Renders regenerated from it.
2026-08-15 docs: standardise AGENTS.md, complete spec table, fix flash targets
    AGENTS.md rebuilt on the org template and fact-checked against the design files. README spec table completed (telemetry power, dimensions, 1.0 mm PCB for all variants) and maintainer added. FLASHING.md build targets corrected to opendrone.rx_2400.lite / .lite_ufl. DOC text variables cleaned of em dashes.
2026-08-22 3D models: retarget to KiCad stock, fix placement
    Replaces easyeda2kicad 3D models with KiCad's own where a dimension-matched
    equivalent exists. The easyeda models run 20-100x denser for the same package
    and most carry the LCEDA watermark modelled as raised geometry, which renders
    on every CAD picture of the board and is not on the real part.
    Only the (model ...) reference, offset and rotation are touched. No footprint,
    pad, land pattern, net, placement or value is modified. Applied to the footprint
    LIBRARY and the boards together: fixing only the .pretty is invisible because
    each board carries its own footprint copy, and fixing only the .kicad_pcb is
    surface level because the next placemen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
    [OpenRX-Mono.kicad_pcb]
2026-08-25 sch: standardise LCSC/Manufacturer/MPN fields across all variants
    Migrated LCSC part numbers out of variant-specific LCSC_Part fields into
    the standard LCSC field, and backfilled Manufacturer/MPN from the LCSC
    catalogue, on all four board variants (Gemini, Lite, Lite-UFL, Mono) and
    the shared ESP32-C3/SX1281 RX core sheet.
    kicad-skip reflowed each file on save, so the diffs are large but purely
    formatting; a structural S-expression diff and ERC re-run on all 12
    affected schematics (including the 4 unmodified top-level sheets) confirm
    only property values changed, no nets/placement/footprints touched.
    Known gap: L2/L3 in OpenRX-Gemini/esp32c3_lr1121_gemini.kicad_sch carry
    LCSC C1035, which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
    [esp32c3_lr1121_mono.kicad_sch]
2026-08-31 AGENTS.md: sync from the bench mirror rework (#45)
    Formatting repairs plus verified corrections from the 2026-08-31 bench
    session (fact-checked against datasheets, board READMEs and firmware
    sources). Details per file in OpenDrone-Testing commit 06034b3.
2026-09-01 chore: standardize OpenRX design assets
    [OpenRX-Mono.kicad_pcb]
2026-09-01 Adopt shared KiCad datasheets
2026-09-01 Split board into its own hardware repository
    [OpenRX-Mono-B_Courtyard.gbr, OpenRX-Mono-B_Cu.gbl, OpenRX-Mono-B_Cu.gbr, OpenRX-Mono-B_Fab.gbr, OpenRX-Mono-B_Mask.gbr, OpenRX-Mono-B_Mask.gbs, OpenRX-Mono-B_Paste.gbp, OpenRX-Mono-B_Paste.gbr]
2026-09-02 Reorder AGENTS.md sections: design first, agent mechanics last
    New order: Architecture, (Voltage envelope,) Power, Key parts, Connectors
    and I/O, (GPIO map, Using it on a base,) Layout rules, Firmware, Repo,
    (Parts and datasheets,) Environment, Rules, Revisions.
    Claude-Session: https://claude.ai/code/session_01GiFxVPcfpNcHY5feGsgG83
2026-09-09 Give every placed part an LCSC field
    The BOM exporter reads a field named LCSC. Parts that carried only
    "LCSC Part" were dropped from the supplier BOM and the pick and place
    without a warning, and ESP32-C3, the 15uH DC-DC inductor and
    SKY13373-460LF carried no LCSC anywhere.
    Adds LCSC to the schematic symbols and mirrors it onto the board
    footprints, which is the only route for references created by a
    replicated hierarchical sheet. Numbers verified against the LCSC
    catalogue: ESP32-C3FH4 C2858491, MLZ2012M150WT000 C383402,
    SKY13373-460LF C150853. Bare test pads stay without a part number.
    Claude-Session: https://claude.ai/c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
    [OpenRX-Mono.kicad_pcb, esp32c3_lr1121_mono.kicad_sch]
2026-09-09 Set the titleblock revision to rev2
    quote_pack.py syncs the titleblock from the release stem; recording it
    keeps the design source stable across exports.
    Claude-Session: https://claude.ai/code/session_01HXA6SP2VEuBZn7yMrez3es
    [OpenRX-Mono.kicad_pcb]
2026-11-11 docs(rules): kicad-skip cannot round-trip KiCad 10 schematics (#10)
    Syncs the shared Rules section from OpenDrone-hw/hardware-template (PR 16).
2026-11-14 README: describe OpenRX as a general-purpose radio control receiver module (#11)
    Requested by Stan, 14 Nov 2026: "fix the public readme's".
    - Opening lines: ExpressLRS radio control receiver module with telemetry, for cars, boats, robots and aircraft; technical facts unchanged.
    - Connection: serial (CRSF) on the RX/TX pads to a controller; a flight controller is named as one example.
    - PWM output is not claimed: the shipped ExpressLRS layout for this board defines no `pwm_outputs`, so the web UI offers no PWM channels.
    README text only; no KiCad files touched.
    Founder-session: 2026-11-14: Stan, 14 Nov 2026: "fix the public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
